Enrico39/kARt-IoT-Lab/media/kart-image-2.png

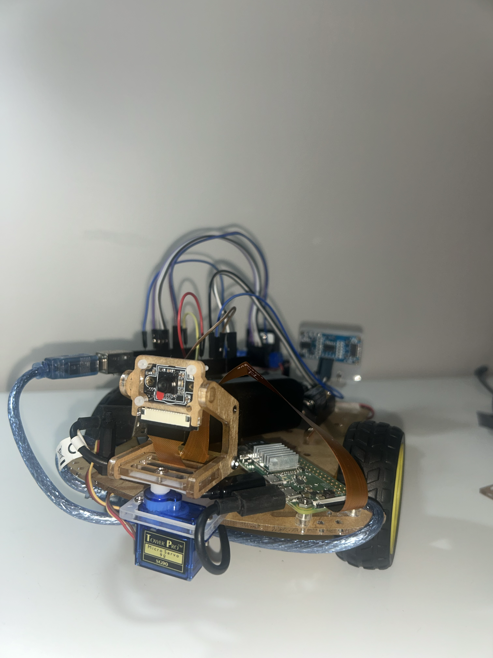
media/kart-image-2.png
