Enrico39/kARt-IoT-Lab/media/kart-image-1.png

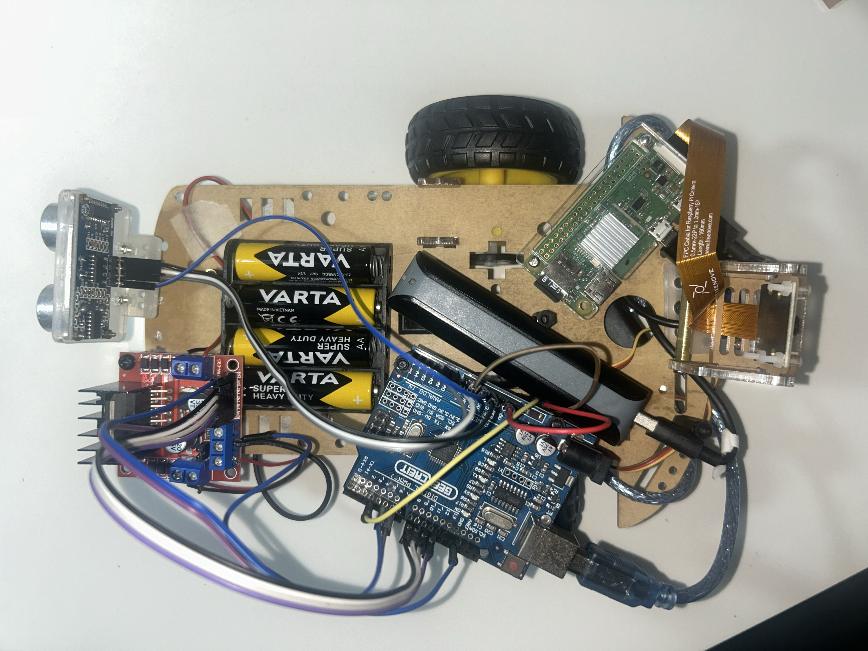
media/kart-image-1.png
