Enrico39/kARt-IoT-Lab/code/kARt/Assets/ARKart/Materials/Griglia.png

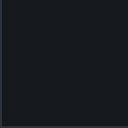
code/kARt/Assets/ARKart/Materials/Griglia.png
