Enrico39/kARt-IoT-Lab/(commit log)

2026-10-22 Presentazione in inglese al posto di quella italiana
    La slide Node-RED ora include lo schema del flow e il salvataggio
    dei dataset CSV. La versione italiana resta solo in locale.
2026-10-22 Slide servo: angolo della camera ±45°
2026-10-22 Slide servo: visuale più ampia grazie alla rotazione della camera
2026-10-23 Pi: streaming MJPEG della camera e driver IMX219
    - arkart_camera.py: picamera2 + encoder MJPEG hardware, 640x480 a 30 FPS su
    http://<pi>:8080/stream.mjpg, un solo write per fotogramma e TCP_NODELAY
    (da 13,5 a ~23 FPS sul Wi-Fi)
    - arkart-camera.service: servizio separato dal bridge
    - setup_pi.sh: installa i due servizi e forza dtoverlay=imx219 (la Freenove
    8MP non viene rilevata in automatico)
2026-10-23 Quest: video FPV, client MQTT e interruttore del passthrough
    - MjpegStream.cs: riceve lo stream della Pi nel pannello video, tiene solo
    l'ultimo fotogramma e si riconnette da solo; stato LIVE e FPS nell'HUD
    - MqttClient.cs + KartMqtt.cs: client MQTT 3.1.1 minimo (decisione D9),
    pubblica arkart/quest/status con Last Will e arkart/quest/metrics a 1 Hz
    - KartLink.cs: conta i comandi non confermati entro 500 ms (lost_pkts)
    - KartPassthrough.cs: tasto X per coprire la stanza con un ambiente virtuale
    (skybox e pavimento a griglia)
    - ARKartSetup.cs: il menu collega tutto, menu e metodo BatchBuild per l'APK
    - project.md aggiornato (§3.5, §4.2, §4.3, D9)
2026-10-23 Node-RED: nuovo layout della dashboard, simulatore spento
    - Quattro riquadri compatti in alto, con il nuovo Link Quest (RTT, video,
    comandi persi, batteria del visore)
    - Eventi accanto al grafico della distanza, configurazione con i comandi
    - Distanza limitata a 100 cm (niente buchi quando il sensore non vede nulla),
    linee di soglia per frenata e rallentamento, assi con unità
    - Flow Simulatore disattivato
2026-10-23 Console: tasti j/l per far girare una sola ruota
    Mostra anche il comando di ciascuna ruota dopo il mixing, utile per provare
    i motori da remoto con la guida via UDP.
2026-10-23 README in inglese e backup della config Node-RED fuori dal repo
    - README tradotto in inglese, senza la sezione Stato; aggiunti porte, avvio
    di Node-RED, comandi del controller e IP della Pi da impostare in KartLink;
    struttura allineata al repo (niente cartella docs/)
    - .config.*.json.backup di Node-RED tolti dal repo e ignorati: contenevano
    il _credentialSecret
2026-10-24 Keynote su Git LFS, sezione Demo nel README e console di amministrazione
